N3kuso/ProjetIoT_MP/IoT_Kicad_MP/IoT_Kicad_MP.kicad_pcb

## KiCad design IoT_Kicad_MP/IoT_Kicad_MP.kicad_pcb (2024-10-24)

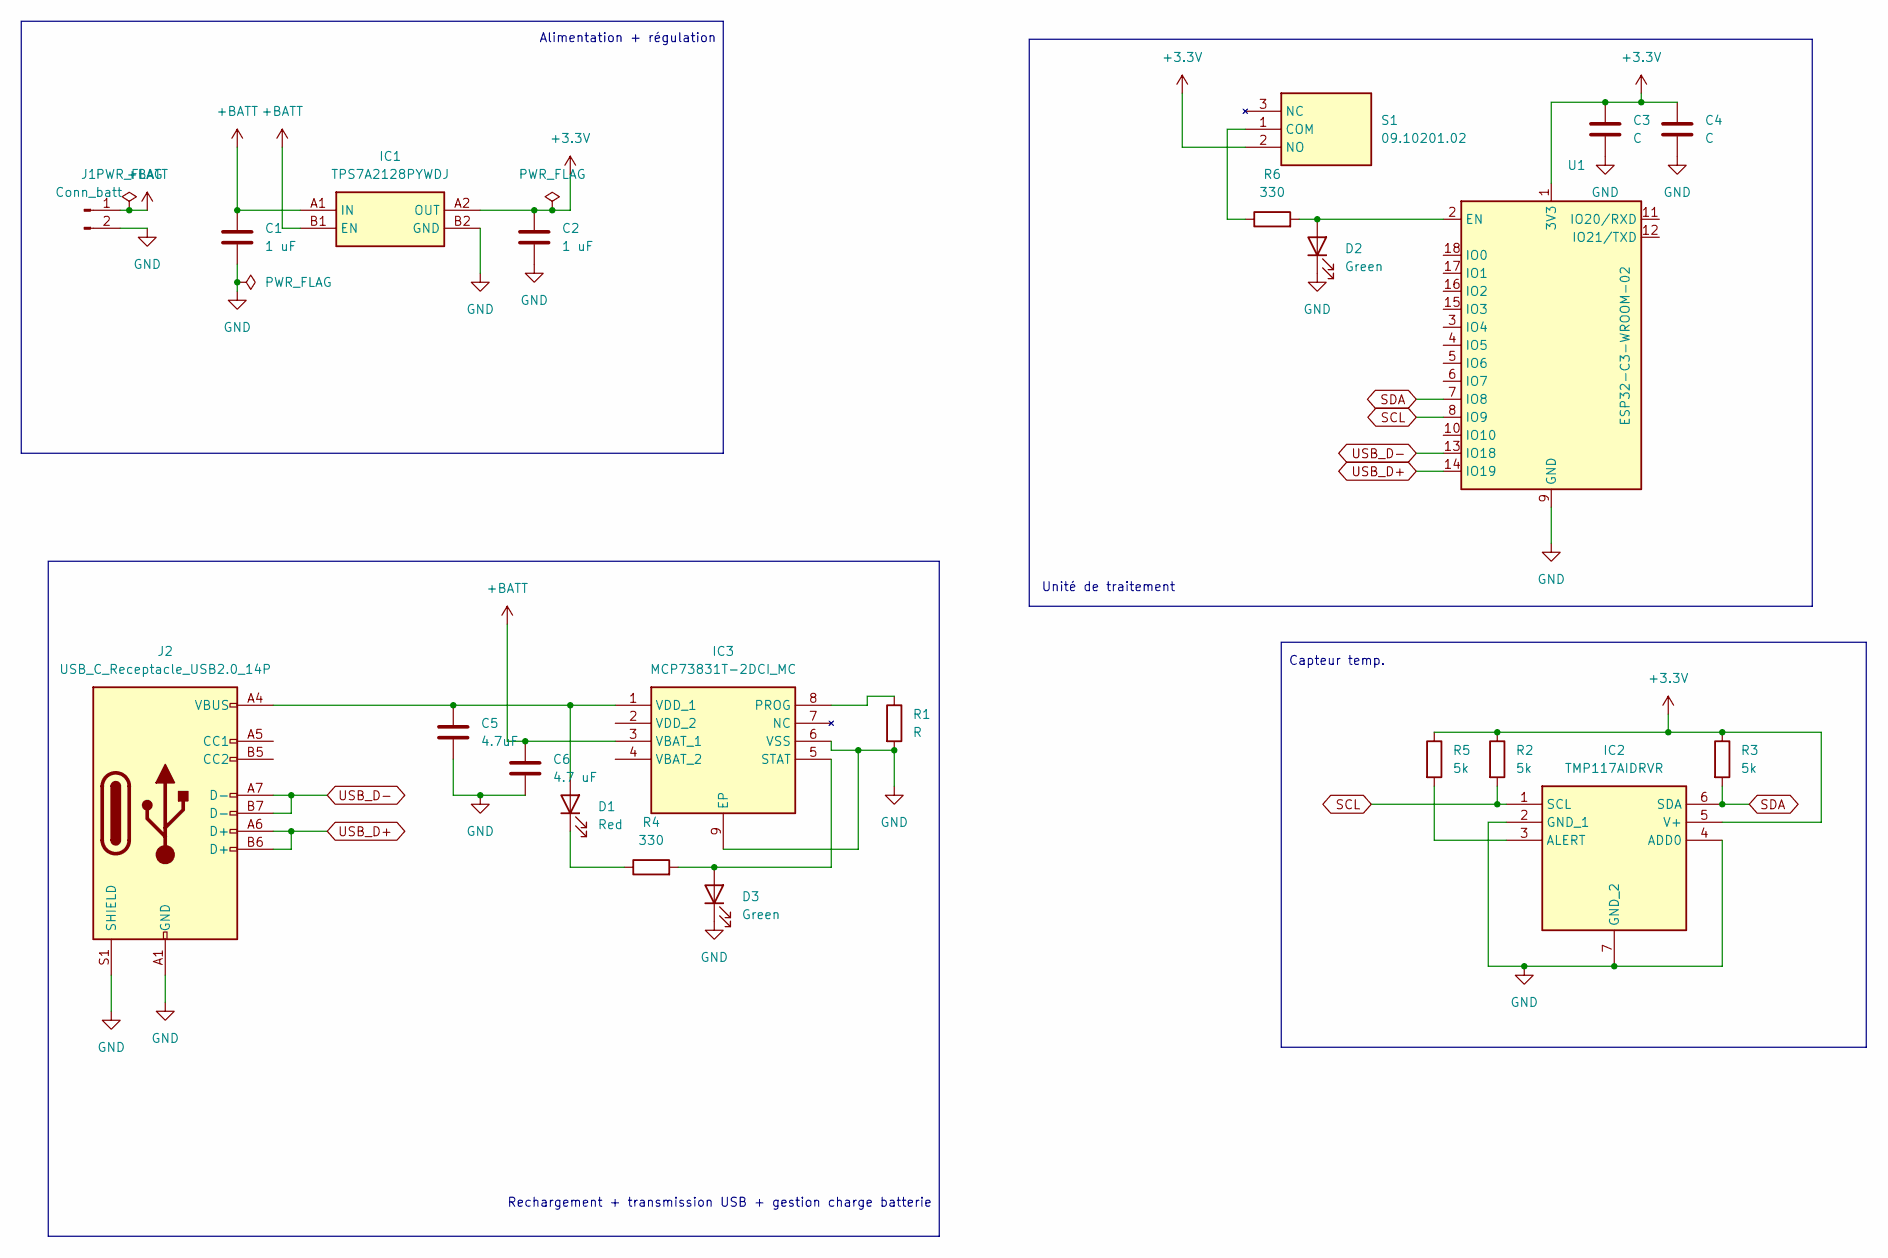
[picture p1: schematic IoT_Kicad_MP.kicad_sch]

Parts:
C1, C2: 1 uF; C_0805_2012Metric
C3, C4: C; C_0805_2012Metric
C5: 4.7uF; C_0805_2012Metric
C6: 4.7 uF; C_0805_2012Metric
D1: Red; LED_0805_2012Metric
D2, D3: Green; LED_0805_2012Metric
IC1: TPS7A2128PYWDJ; Manufacturer_Part_Number TPS7A2128PYWDJ; Mouser Part Number 595-TPS7A2128PYWDJ
IC2: TMP117AIDRVR; SON65P200X200X80-7N; Manufacturer_Part_Number TMP117AIDRVR; Mouser Part Number 595-TMP117AIDRVR
IC3: MCP73831T-2DCI_MC; SON50P300X200X100-9N-D; Manufacturer_Part_Number MCP73831T-2DCI/MC; Mouser Part Number 579-MCP73831T-2DCIMC
J1: Conn_batt; SolderWire-0.1sqmm_1x02_P3.6mm_D0.4mm_OD1mm
J2: USB_C_Receptacle_USB2.0_14P; USB_C_Receptacle_JAE_DX07S016JA1R1500
R1: R; R_0805_2012Metric
R2, R3, R5: 5k; R_0805_2012Metric
R4, R6: 330; R_0805_2012Metric
S1: 09.10201.02; 091020102; Manufacturer_Part_Number 09.10201.02; Mouser Part Number 123-09.10201.02
U1: ESP32-C3-WROOM-02

Connections:
+3.3V: C2.1, C3.1, C4.1, IC1.A2 (OUT), IC2.5 (V+), R2.1, R3.1, R5.1, S1.2 (NO), U1.1 (3V3)
+BATT: C1.1, C6.1, IC1.A1 (IN), IC1.B1 (EN), IC3.3 (VBAT_1), J1.1
GND: C1.2, C2.2, C3.2, C4.2, C5.2, C6.2, D2.1 (K), D3.1 (K), IC1.B2 (GND), IC2.2 (GND_1), IC2.4 (ADD0), IC2.7 (GND_2), IC3.6 (VSS), IC3.9 (EP), J1.2, J2.A1 (GND), J2.A12 (GND), J2.B1 (GND), J2.B12 (GND), J2.S1 (SHIELD), R1.2, U1.9 (GND), U1.19 (GND)
unnamed: C5.1, D1.2 (A), IC3.1 (VDD_1), J2.A4 (VBUS), J2.A9 (VBUS), J2.B4 (VBUS), J2.B9 (VBUS)
unnamed: D1.1 (K), R4.1
unnamed: D2.2 (A), R6.2, U1.2 (EN)
unnamed: D3.2 (A), IC3.5 (STAT), R4.2
unnamed: IC2.3 (ALERT), R5.2
unnamed: IC3.8 (PROG), R1.1
unnamed: R6.1, S1.1 (COM)
SCL: IC2.1 (SCL), R2.2, U1.8 (IO9)
SDA: IC2.6 (SDA), R3.2, U1.7 (IO8)
USB_D+: J2.A6 (D+), J2.B6 (D+), U1.14 (IO19)
USB_D-: J2.A7 (D-), J2.B7 (D-), U1.13 (IO18)

Notes on the sheet:
Alimentation + régulation
Rechargement + transmission USB + gestion charge batterie
Capteur temp.
Unité de traitement

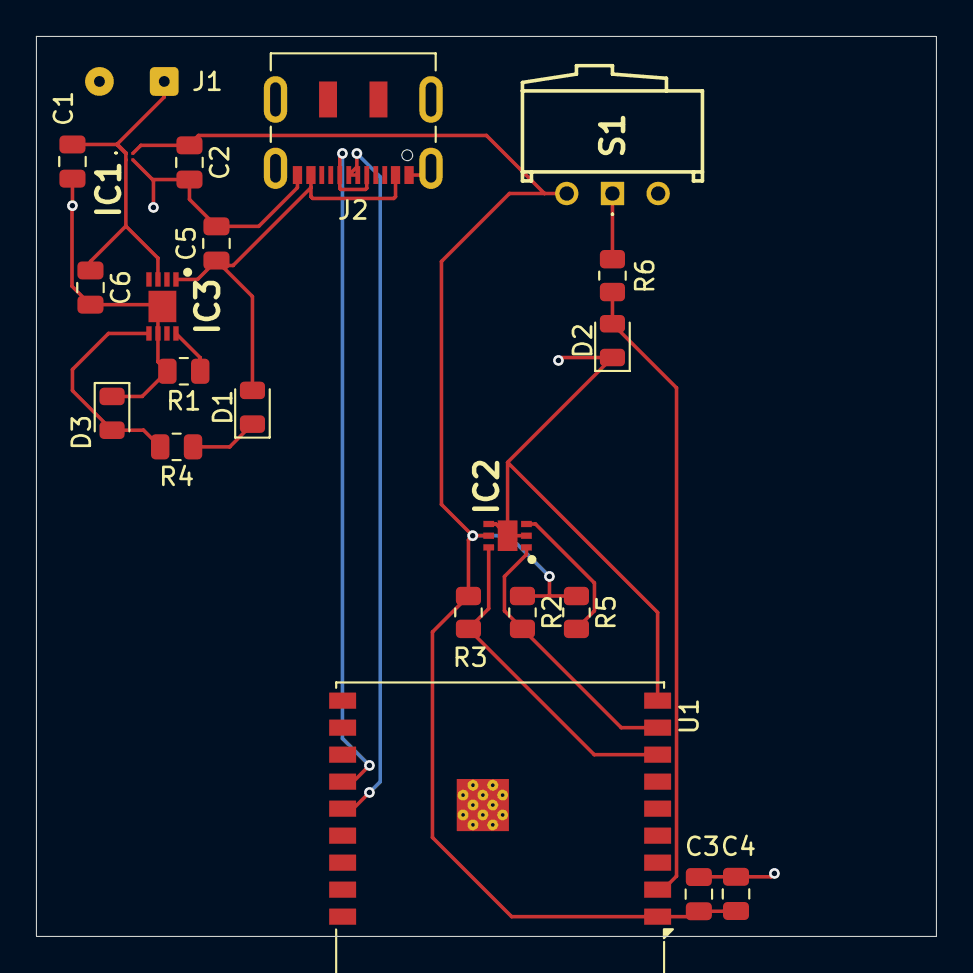
[picture p2: board IoT_Kicad_MP.kicad_pcb from above]

Board: 2 copper layers, 50.0 x 50.0 mm, 22 parts (0 on the bottom side), 14 nets.
